Bastlirovo/sharp-memory-lcd-esp32s2/README.md

# sharp-memory-lcd-esp32s2
Project for ESP32-S2 devboard with connector for Sharp Memory LCD
