Bastlirovo/sharp-memory-lcd-esp32s2/HW/sharp_esp32s2_v1_top.png

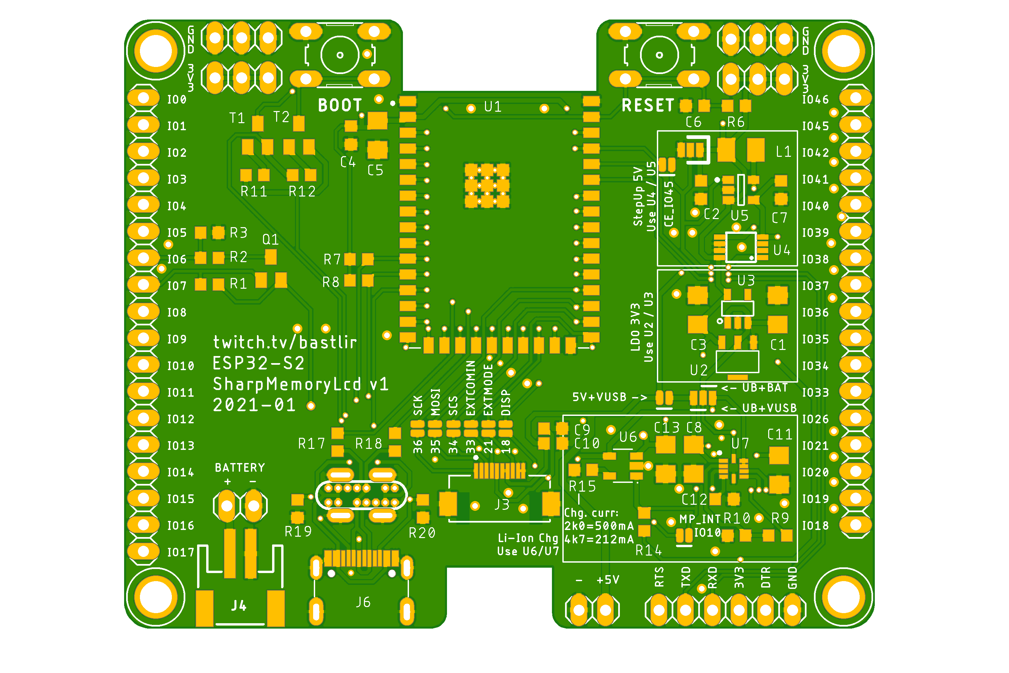
HW/sharp_esp32s2_v1_top.png
