Bastlirovo/sharp-memory-lcd-esp32s2/3D/ESP_Sharp_horni_v2.stl

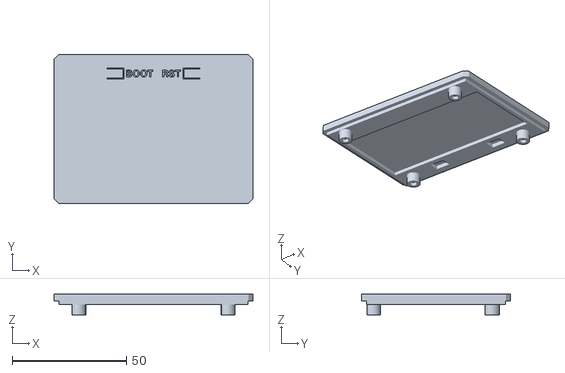
[picture p2: CAD file, 2021-03-03]
3D/ESP_Sharp_horni_v2.stl
87.3 x 65.3 x 9.00
