Bastlirovo/sharp-memory-lcd-esp32s2/3D/Sharp_18650/ESP_Sharp_spodni_v1.stl

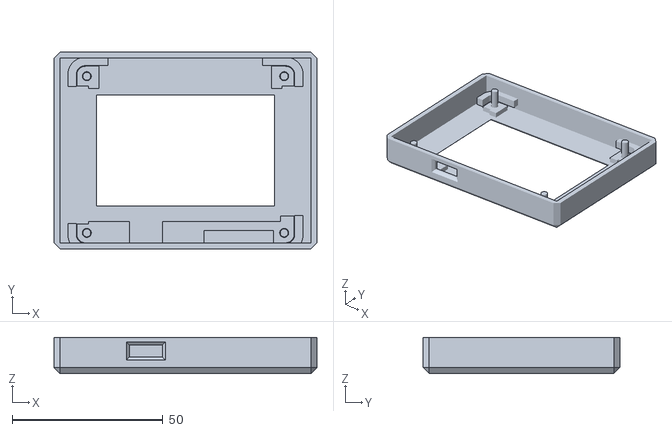
[picture p3: CAD file, 2021-11-17]
3D/Sharp_18650/ESP_Sharp_spodni_v1.stl
87.3 x 65.3 x 12.0
