Bastlirovo/sharp-memory-lcd-esp32s2/3D/Sharp_18650/ESP_Sharp_horni_v4.stl

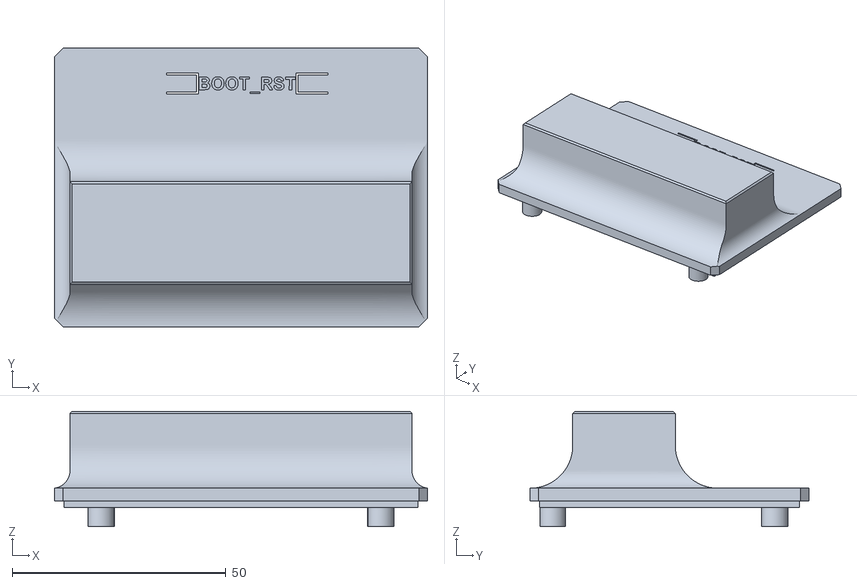
[picture p4: CAD file, 2021-11-17]
3D/Sharp_18650/ESP_Sharp_horni_v4.stl
87.3 x 65.3 x 27.0
