Bastlirovo/sharp-memory-lcd-esp32s2/(list of files, cad)

Other CAD files:
3D/ESP_Sharp_spodni_v2.stl
