Bastlirovo/sharp-memory-lcd-esp32s2/HW/sharp_esp32s2_v1.pdf

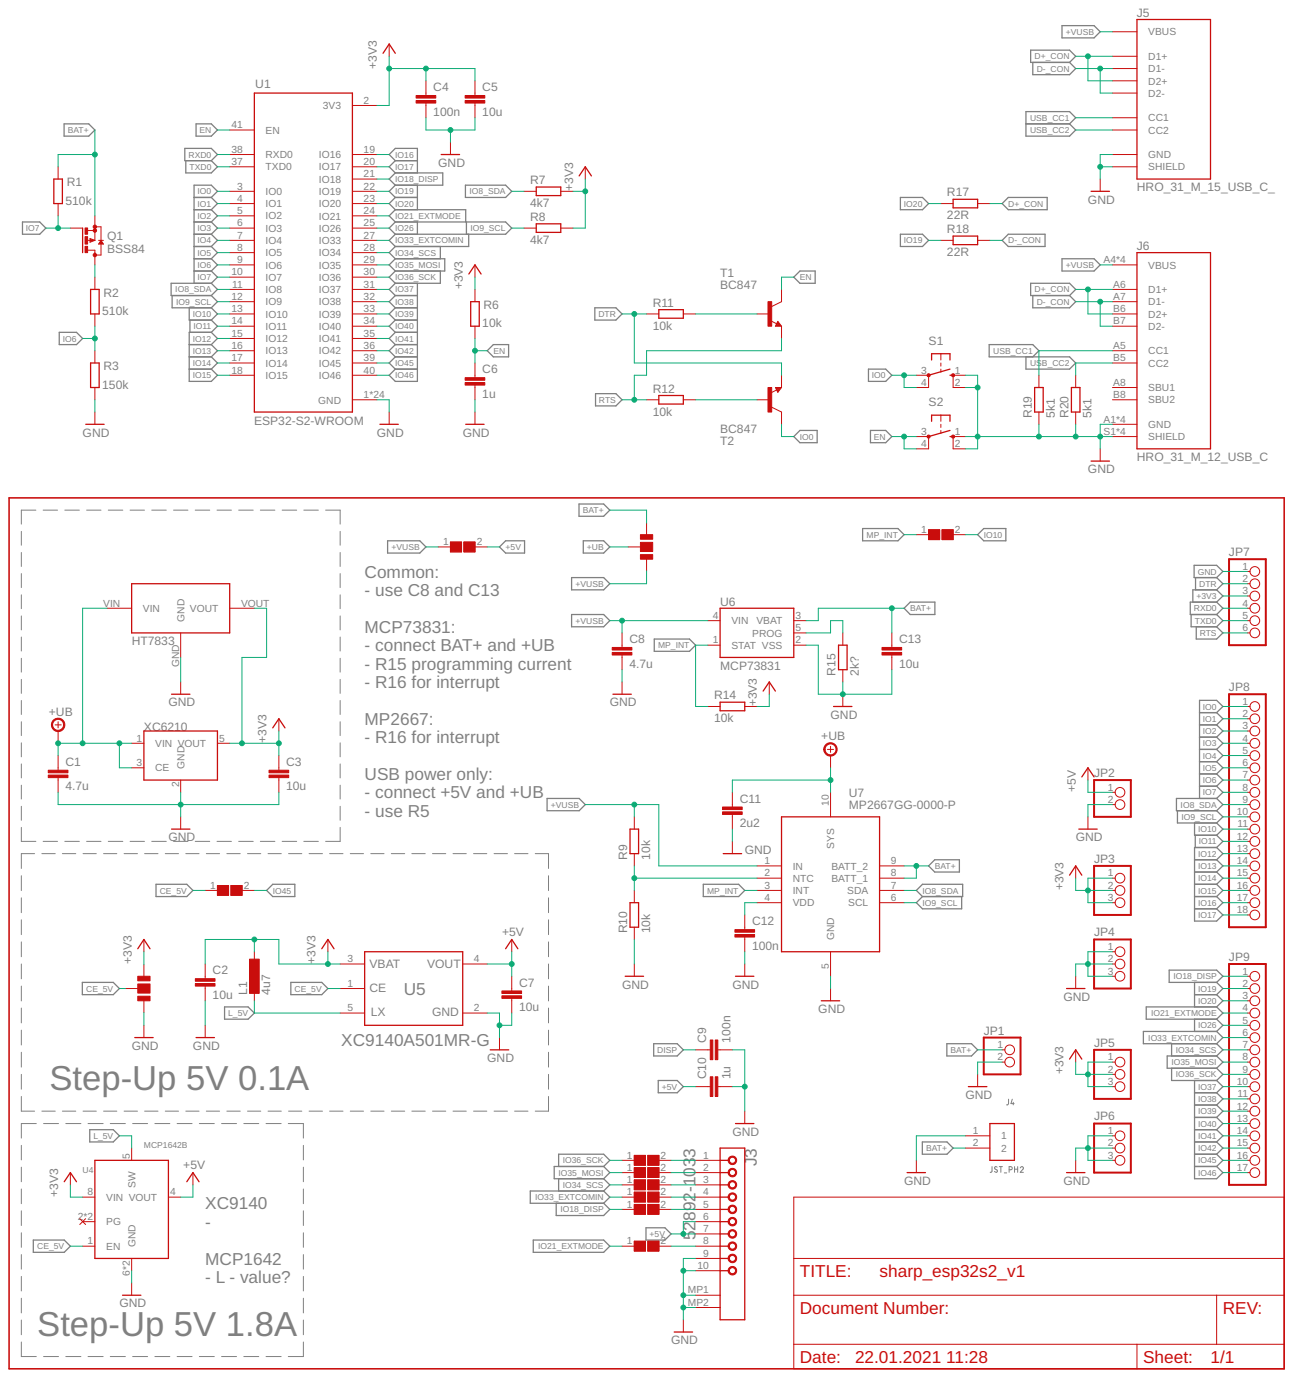
[picture p5: page 1]

TXD0 | IO17 21

IO0 4 | IO19 | IO8_SDA
5 IO2 | 24 IO21_EXTMODE
6 IO3 | 25 IO26

MCP73831: - connect BAT+ and +UB

- R15 programming current - R16 for interrupt

USB power only: - connect +5V and +UB
