Bastlirovo/sharp-memory-lcd-esp32s2/HW/sharp_esp32s2_v1.brd

## EAGLE design HW/sharp_esp32s2_v1.brd (2021-02-14)

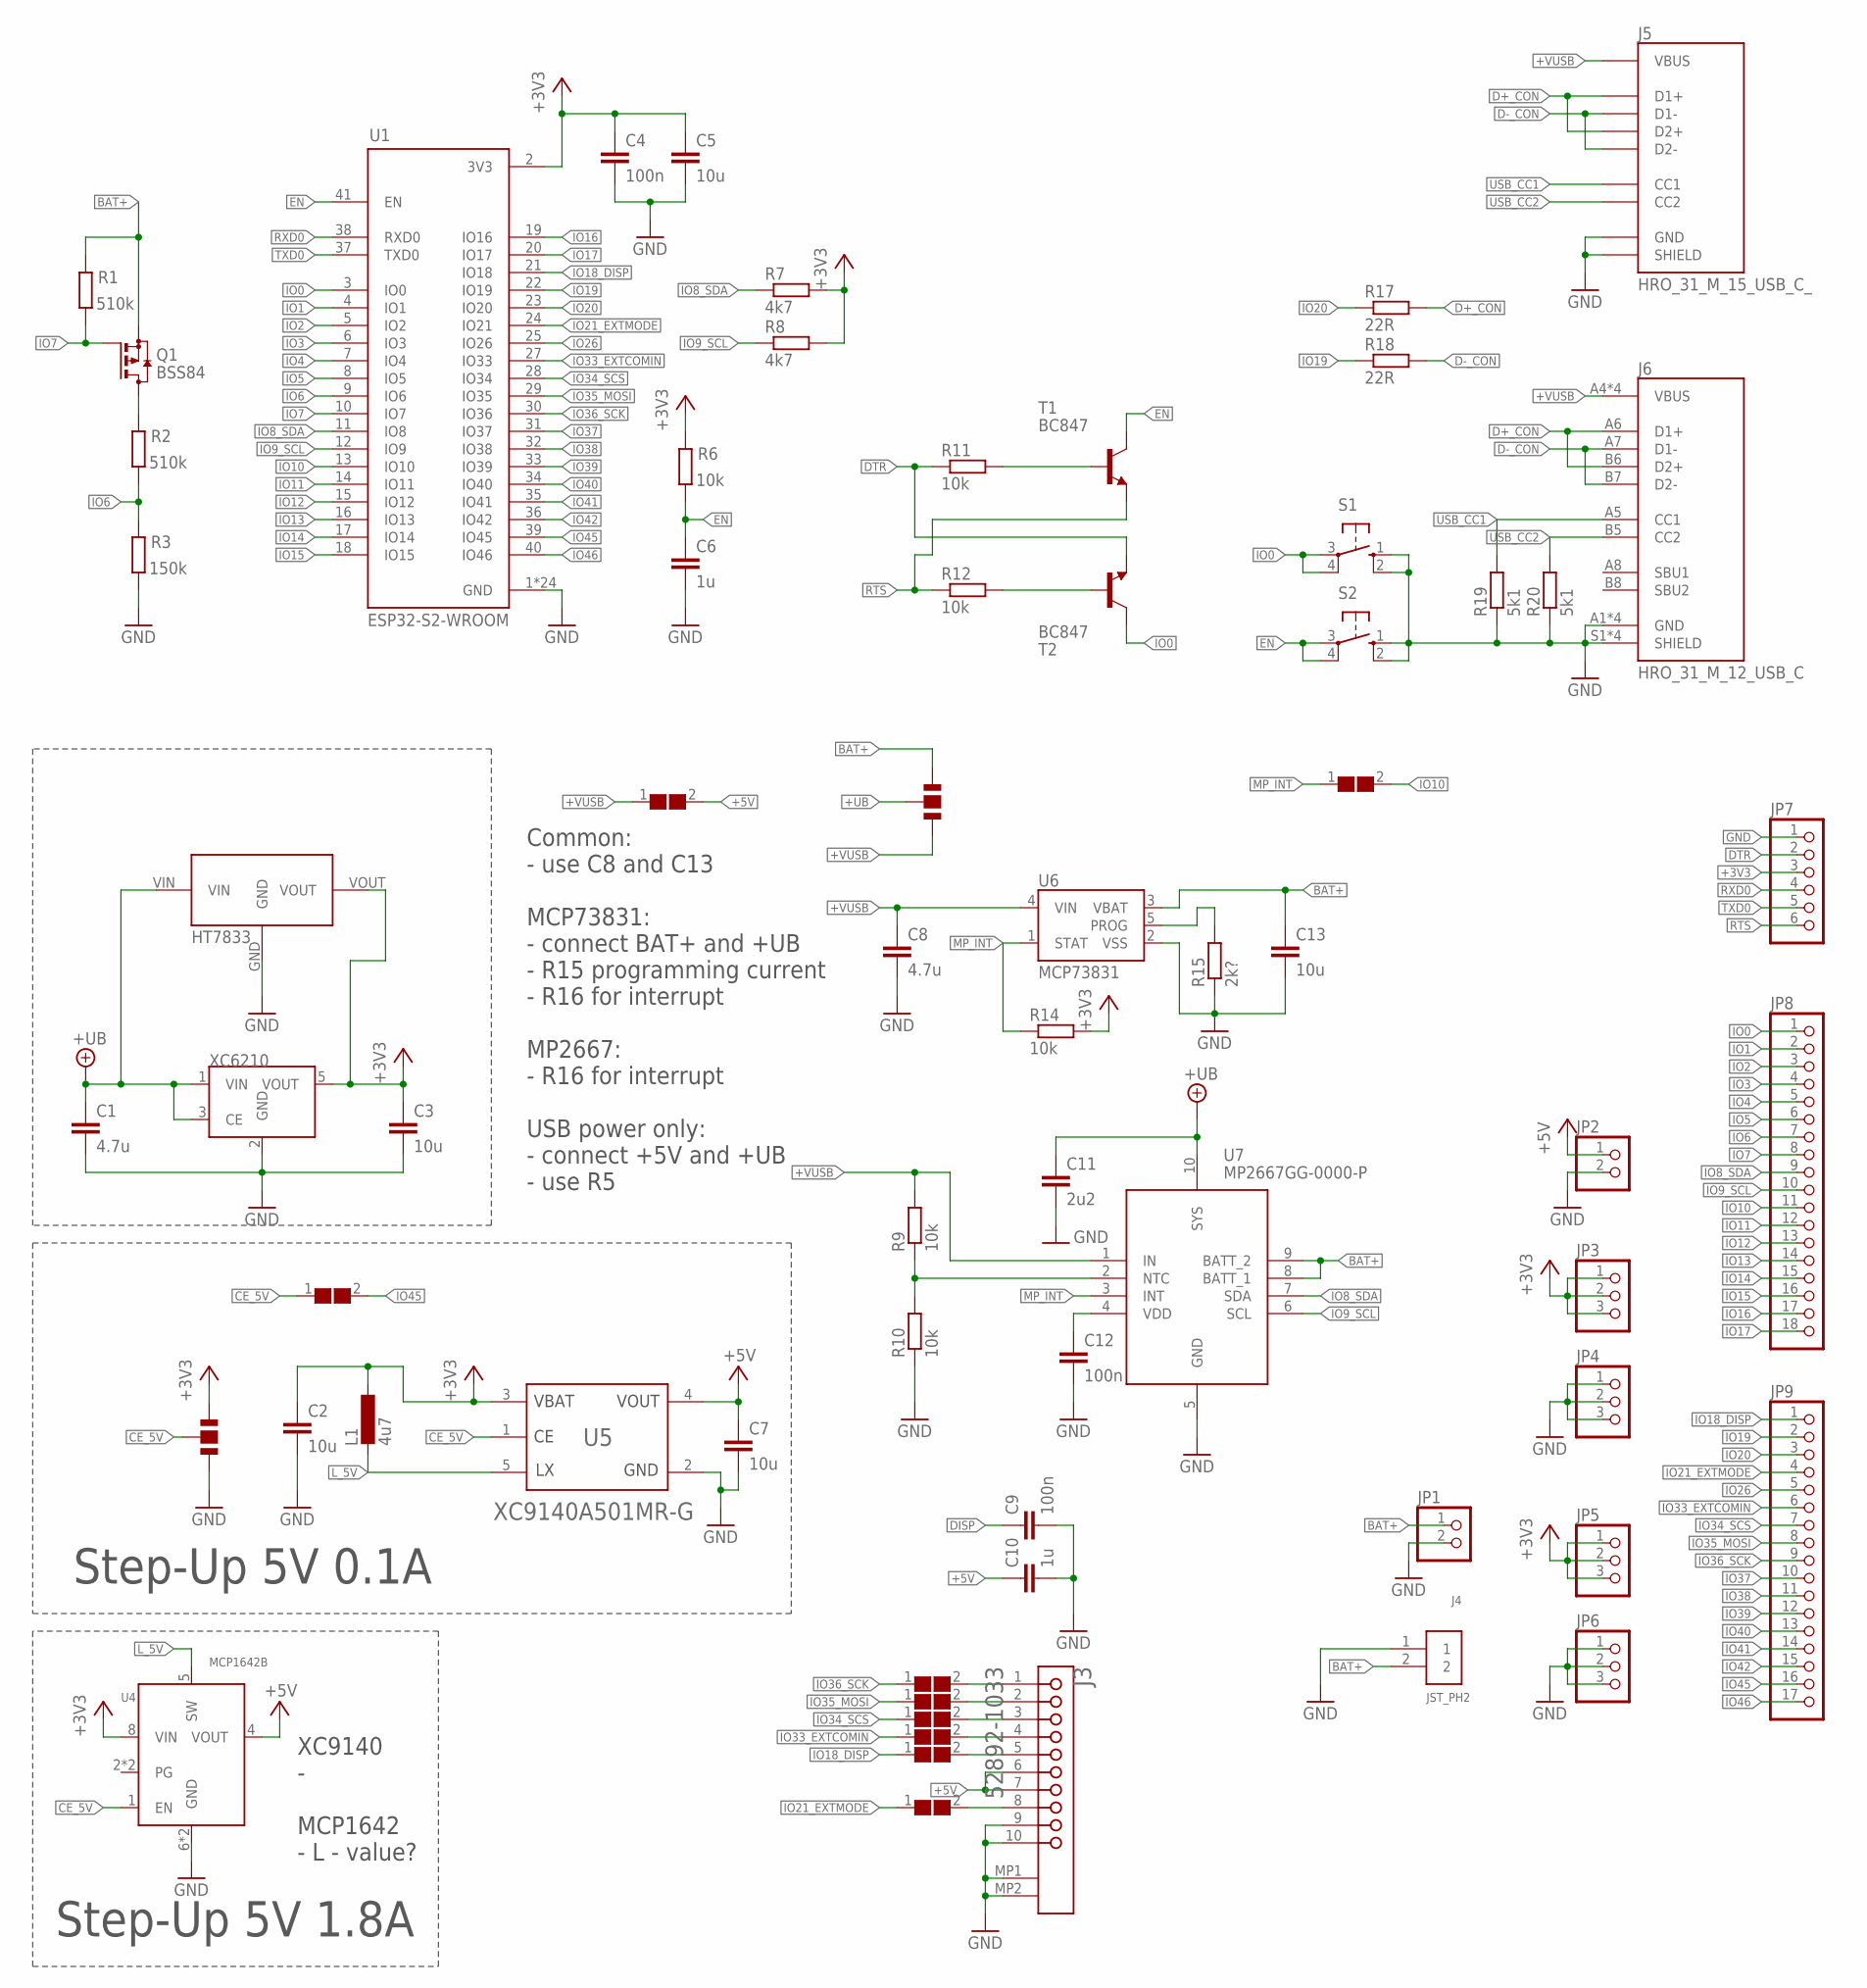
[picture p6: schematic sharp_esp32s2_v1.sch]

Parts:
C1, C8: 4.7u; C1206
C2, C7: 10u; C0603K
C3, C5, C13: 10u; C1206
C4, C9, C12: 100n; C0603K
C6, C10: 1u; C0603K
C11: 2u2; C1206
J1, J2: JUMPER; 2-WAY
J3: MOLEX_52892-1033MOLEX_52892-1033_0_0; MOLEX_52892-1033_0
J4: JST_PH2; JSTPH2
J5: HRO_31_M_15_USB_C_; HRO_31_M_15_USB_C
J6: HRO_31_M_12_USB_C
JP1, JP2: PINHD-1X2; 1X02
JP3, JP4, JP5, JP6: PINHD-1X3; 1X03
JP7: PINHD-1X6; 1X06
JP8: PINHD-1X18; 1X18
JP9: PINHD-1X17; 1X17
L1: 4u7; L3225M
Q1: BSS84; SOT23
R1, R2: 510k; R0603
R3: 150k; R0603
R6, R9, R10, R11, R12, R14: 10k; R0603
R7, R8: 4k7; R0603
R15: 2k?; R0603
R17, R18: 22R; R0603
R19, R20: 5k1; R0603
S1, S2: 10-XX; B3F-10XX
T1, T2: BC847; SOT23
U1: ESP32-S2-WROOM; XCVR_ESP32-S2-WROOM
U2: HT7833; SOT89
U3: XC6210; SOT-23-5
U4: MCP1642B; MSOP8
U5: TOREX_XC9140A501MR-GTOREX_XC9140A501MR-G_0_0; TOREX_XC9140A501MR-G_0
U6: MCP73831; SOT95P290X120-5
U7: MP2667GG-0000-P; QFN50P200X200X105-10N
U$1, U$2, U$3, U$4, U$5, U$6, U$7, U$8, U$9: SOLDER_JUMPER

Connections:
+3V3: C2.1, C3.1, C4.1, C5.1, J1.P$3, JP3.1, JP3.2, JP3.3, JP5.1, JP5.2, JP5.3, JP7.3, L1.1, R6.2, R7.2, R8.2, R14.2, U1.2 (3V3), U2.VOUT, U3.5 (VOUT), U4.8 (VIN), U5.3 (VBAT)
+5V: C7.1, C10.1, J3.6, J3.7, JP2.1, U4.4 (VOUT), U5.4 (VOUT), U$7.2
+UB: C1.1, C11.1, J2.P$1, U2.VIN, U3.1 (VIN), U3.3 (CE), U7.10 (SYS)
+VUSB: C8.1, J2.P$2, J5.P$2 (VBUS), J5.P$6 (VBUS), J5.P$9 (VBUS), J5.P$13 (VBUS), J6.A4 (VBUS), J6.A9 (VBUS), J6.B4 (VBUS), J6.B9 (VBUS), R9.2, U6.4 (VIN), U7.1 (IN), U$7.1
BAT+: C13.1, J2.P$3, J4.2, JP1.1, Q1.2 (S), R1.2, U6.3 (VBAT), U7.8 (BATT_1), U7.9 (BATT_2)
CE_5V: J1.P$1, U4.1 (EN), U5.1 (CE), U$9.1
D+_CON: J5.P$4 (D1+), J5.P$11 (D2+), J6.A6 (D1+), J6.B6 (D2+), R17.2
D-_CON: J5.P$3 (D1-), J5.P$10 (D2-), J6.A7 (D1-), J6.B7 (D2-), R18.2
DISP: C9.1, J3.5, U$5.2
DTR: JP7.2, R11.1, T2.2 (E)
EN: C6.1, R6.1, S2.3, S2.4 (P1), T1.3 (C), U1.41 (EN)
GND: C1.2, C2.2, C3.2, C4.2, C5.2, C6.2, C7.2, C8.2, C9.2, C10.2, C11.2, C12.2, C13.2, J1.P$2, J3.9, J3.10, J3.MP1, J3.MP2, J4.1, J5.P$1 (GND), J5.P$7 (GND), J5.P$8 (GND), J5.P$14 (GND), J5.P$15 (SHIELD), J5.P$16 (SHIELD), J5.P$17 (SHIELD), J5.P$18 (SHIELD), J6.A1 (GND), J6.A12 (GND), J6.B1 (GND), J6.B12 (GND), J6.S1 (SHIELD), J6.S2 (SHIELD), J6.S3 (SHIELD), J6.S4 (SHIELD), JP1.2, JP2.2, JP4.1, JP4.2, JP4.3, JP6.1, JP6.2, JP6.3, JP7.1, R3.1, R10.1, R15.1, R19.1, R20.1, S1.1 (S), S1.2 (S1), S2.1 (S), S2.2 (S1), U1.1 (GND), U1.26 (GND), U1.42 (GND), U1.43.1 (GND), U1.43.2 (GND), U1.43.3 (GND), U1.43.4 (GND), U1.43.5 (GND), U1.43.6 (GND), U1.43.7 (GND), U1.43.8 (GND), U1.43.9 (GND), U1.43.10 (GND), U1.43.11 (GND), U1.43.12 (GND), U1.43.13 (GND), U1.43.14 (GND), U1.43.15 (GND), U1.43.16 (GND), U1.43.17 (GND), U1.43.18 (GND), U1.43.19 (GND), U1.43.20 (GND), U1.43.21 (GND), U2.GND, U3.2 (GND), U4.6 (GND), U4.7 (GND), U5.2 (GND), U6.2 (VSS), U7.5 (GND)
IO0: JP8.1, S1.3, S1.4 (P1), T2.3 (C), U1.3 (IO0)
IO1: JP8.2, U1.4 (IO1)
IO2: JP8.3, U1.5 (IO2)
IO3: JP8.4, U1.6 (IO3)
IO4: JP8.5, U1.7 (IO4)
IO5: JP8.6, U1.8 (IO5)
IO6: JP8.7, R2.1, R3.2, U1.9 (IO6)
IO7: JP8.8, Q1.1 (G), R1.1, U1.10 (IO7)
IO8_SDA: JP8.9, R7.1, U1.11 (IO8), U7.7 (SDA)
IO9_SCL: JP8.10, R8.1, U1.12 (IO9), U7.6 (SCL)
IO10: JP8.11, U1.13 (IO10), U$8.2
IO11: JP8.12, U1.14 (IO11)
IO12: JP8.13, U1.15 (IO12)
IO13: JP8.14, U1.16 (IO13)
IO14: JP8.15, U1.17 (IO14)
IO15: JP8.16, U1.18 (IO15)
IO16: JP8.17, U1.19 (IO16)
IO17: JP8.18, U1.20 (IO17)
IO18_DISP: JP9.1, U1.21 (IO18), U$5.1
IO19: JP9.2, R18.1, U1.22 (IO19)
IO20: JP9.3, R17.1, U1.23 (IO20)
IO21_EXTMODE: JP9.4, U1.24 (IO21), U$6.1
IO26: JP9.5, U1.25 (IO26)
IO33_EXTCOMIN: JP9.6, U1.27 (IO33), U$4.1
IO34_SCS: JP9.7, U1.28 (IO34), U$3.1
IO35_MOSI: JP9.8, U1.29 (IO35), U$2.1
IO36_SCK: JP9.9, U1.30 (IO36), U$1.1
IO37: JP9.10, U1.31 (IO37)
IO38: JP9.11, U1.32 (IO38)
IO39: JP9.12, U1.33 (IO39)
IO40: JP9.13, U1.34 (IO40)
IO41: JP9.14, U1.35 (IO41)
IO42: JP9.15, U1.36 (IO42)
IO45: JP9.16, U1.39 (IO45), U$9.2
IO46: JP9.17, U1.40 (IO46)
L_5V: L1.2, U4.5 (SW), U5.5 (LX)
MP_INT: R14.1, U6.1 (STAT), U7.3 (INT), U$8.1
unnamed: J3.2, U$2.2
unnamed: J3.3, U$3.2
unnamed: J3.4, U$4.2
unnamed: Q1.3 (D), R2.2
unnamed: J3.8, U$6.2
unnamed: R9.1, R10.2, U7.2 (NTC)
unnamed: R15.2, U6.5 (PROG)
unnamed: C12.1, U7.4 (VDD)
unnamed: R12.2, T2.1 (B)
unnamed: R11.2, T1.1 (B)
RTS: JP7.6, R12.1, T1.2 (E)
RXD0: JP7.4, U1.38 (RXD0)
SCK: J3.1, U$1.2
TXD0: JP7.5, U1.37 (TXD0)
USB_CC1: J5.P$5 (CC1), J6.A5 (CC1), R19.2
USB_CC2: J5.P$12 (CC2), J6.B5 (CC2), R20.2

Notes on the sheet:
Step-Up 5V 1.8A
Step-Up 5V 0.1A
Common: - use C8 and C13 MCP73831: - connect BAT+ and +UB - R15 programming current - R16 for interrupt MP2667: - R16 for interrupt USB power only: - connect +5V and +UB - use R5
XC9140 - MCP1642 - L - value?

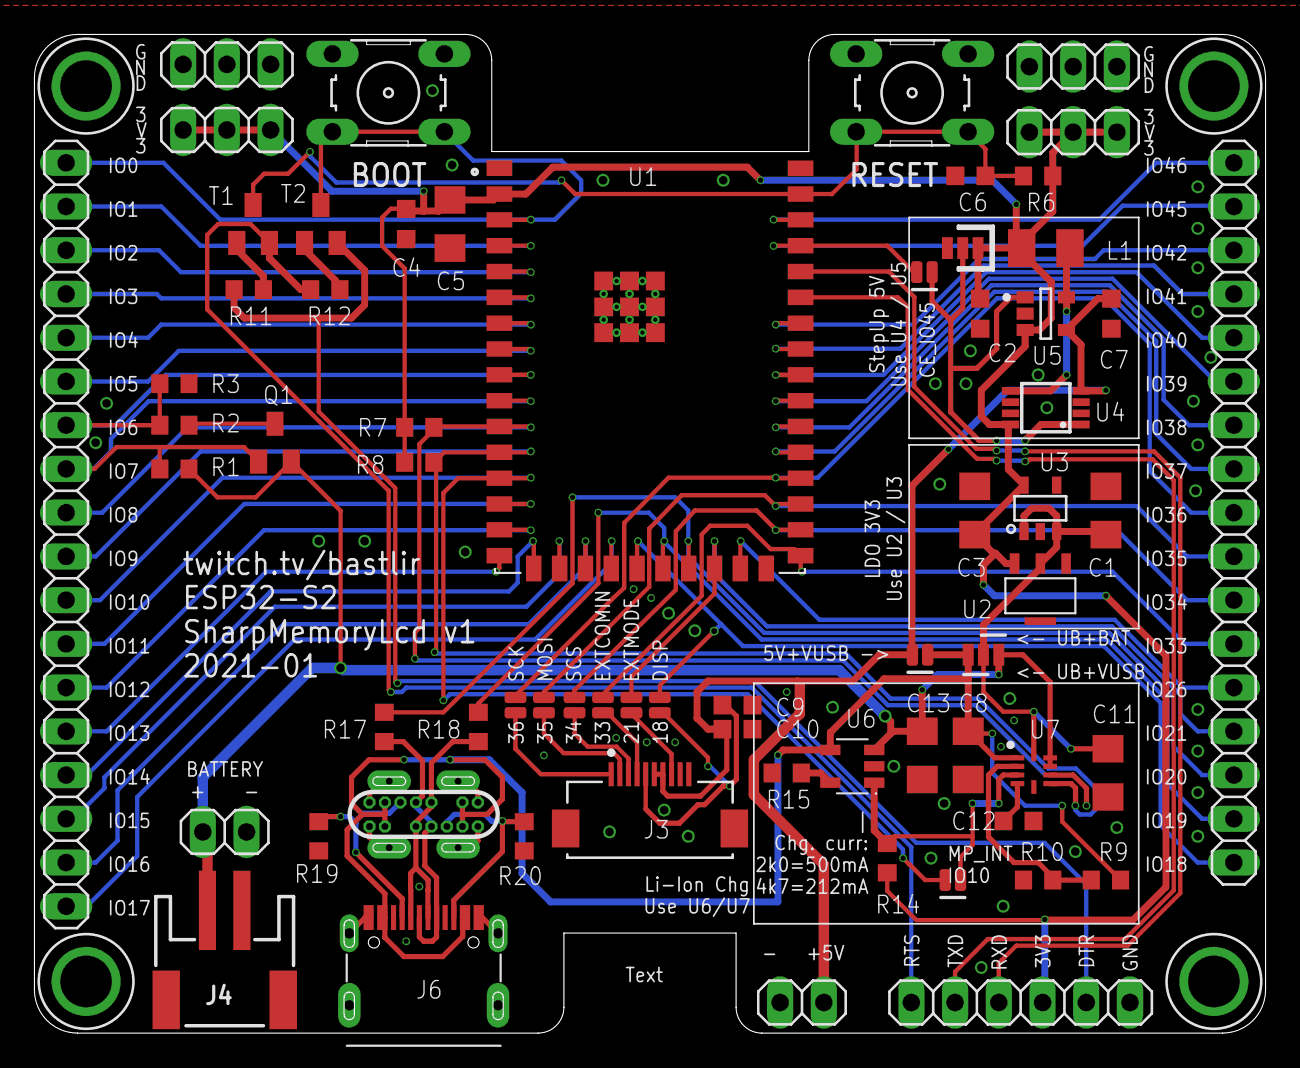
[picture p7: board sharp_esp32s2_v1.brd from above]

Board: 2 copper layers, 71.5 x 58.0 mm, 66 parts (0 on the bottom side), 65 nets.
