Bastlirovo/sharp-memory-lcd-esp32s2/(commit log)

2021-02-14 Initial commit of v1 HW
    [sharp_esp32s2_v1.brd, sharp_esp32s2_v1.sch]
2021-02-14 Added PDF with solder pads manual
2021-02-17 Added example with WiFi and I2C scanners on LCD.
2021-03-03 Commit of 3D models for Sharp ESP Box
    [ESP_Sharp_horni_v2.stl, ESP_Sharp_spodni_v2.stl]
2021-11-17 Added 3D model of box using 18650 battery
    Photos on https://www.instagram.com/p/CPtF8xuLmJq/
    [ESP_Sharp_horni_v4.stl, ESP_Sharp_spodni_v1.stl]
